stasiselectronics/LowNoise5VDC/LowNoise5V - HW Files/Input Files/artwork-bottom.png

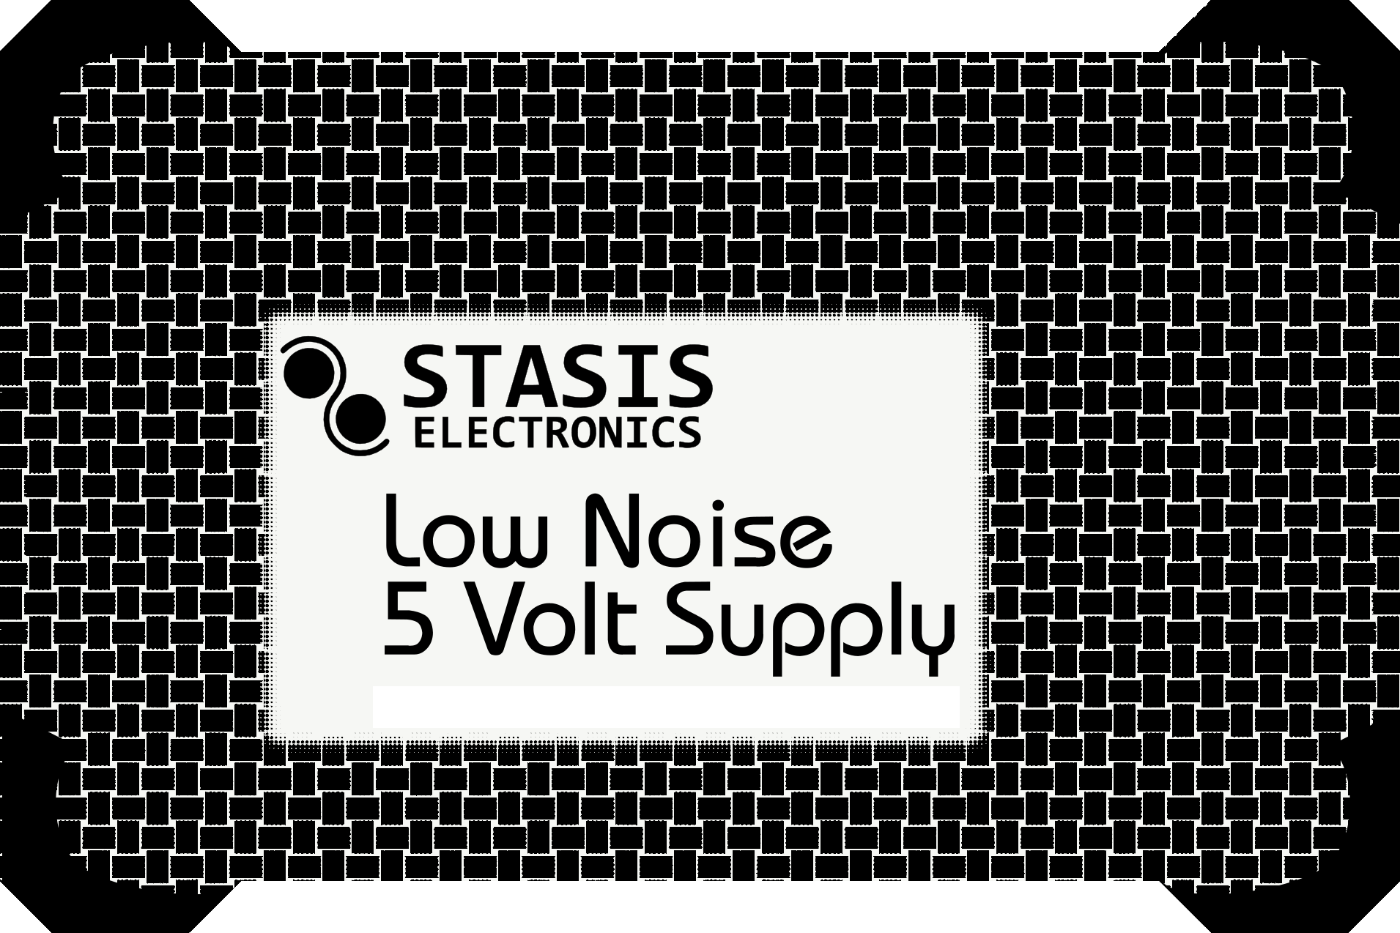
LowNoise5V - HW Files/Input Files/artwork-bottom.png
