stasiselectronics/LowNoise5VDC/LowNoise5V - HW Files/Input Files/artwork-top.png

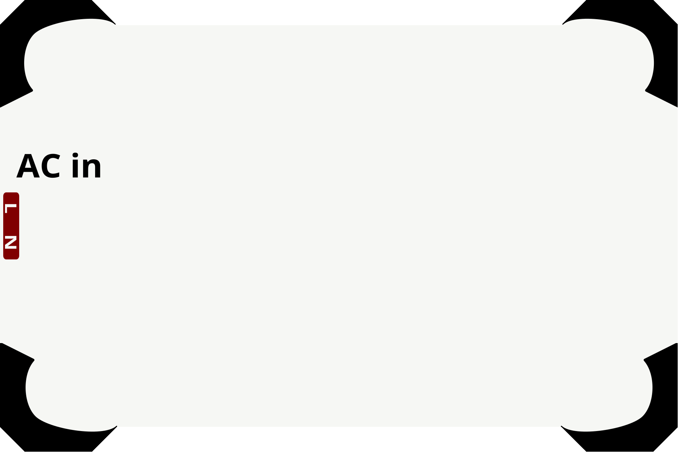
LowNoise5V - HW Files/Input Files/artwork-top.png
