stasiselectronics/LowNoise5VDC/Enclosure Files/Assembly.FCStd

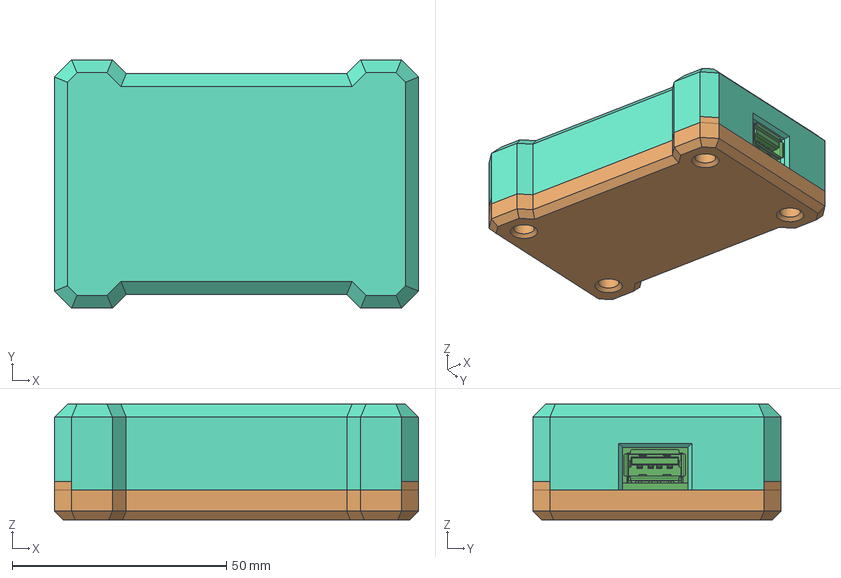
[picture p3: CAD file, 2021-04-17]
Enclosure Files/Assembly.FCStd
85.0 x 58.0 x 27.0 mm
LowNoise5V
