stasiselectronics/LowNoise5VDC/Enclosure Files/STLs/Base.stl

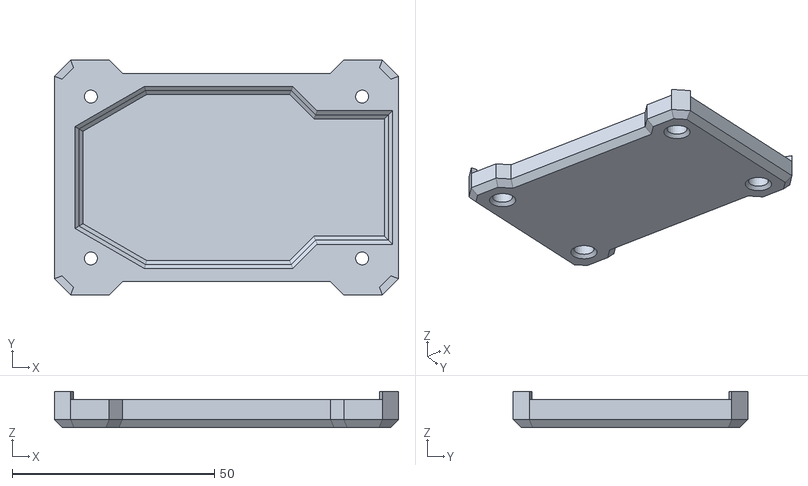
[picture p4: CAD file, 2021-04-17]
Enclosure Files/STLs/Base.stl
85.0 x 58.0 x 9.00
