stasiselectronics/LowNoise5VDC/Enclosure Files/STLs/Top.stl

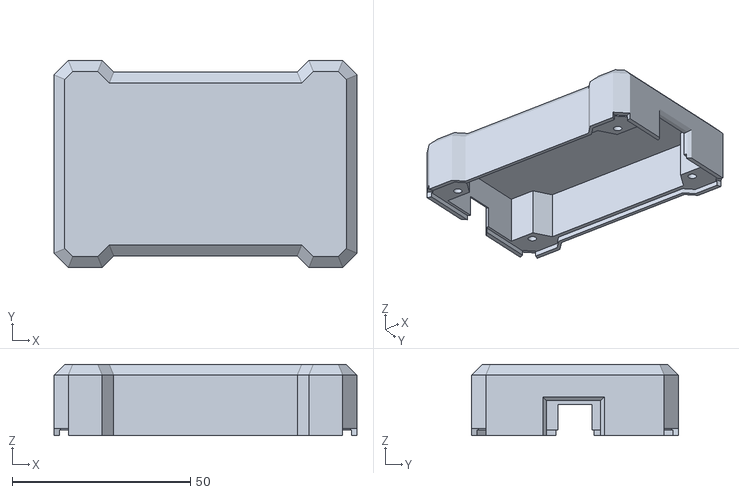
[picture p5: CAD file, 2021-04-17]
Enclosure Files/STLs/Top.stl
85.0 x 58.0 x 20.0
