stasiselectronics/LowNoise5VDC/LowNoise5V - HW Files/LowNoise5V.kicad_pcb

## KiCad design LowNoise5V - HW Files/LowNoise5V.kicad_pcb (2021-04-17)

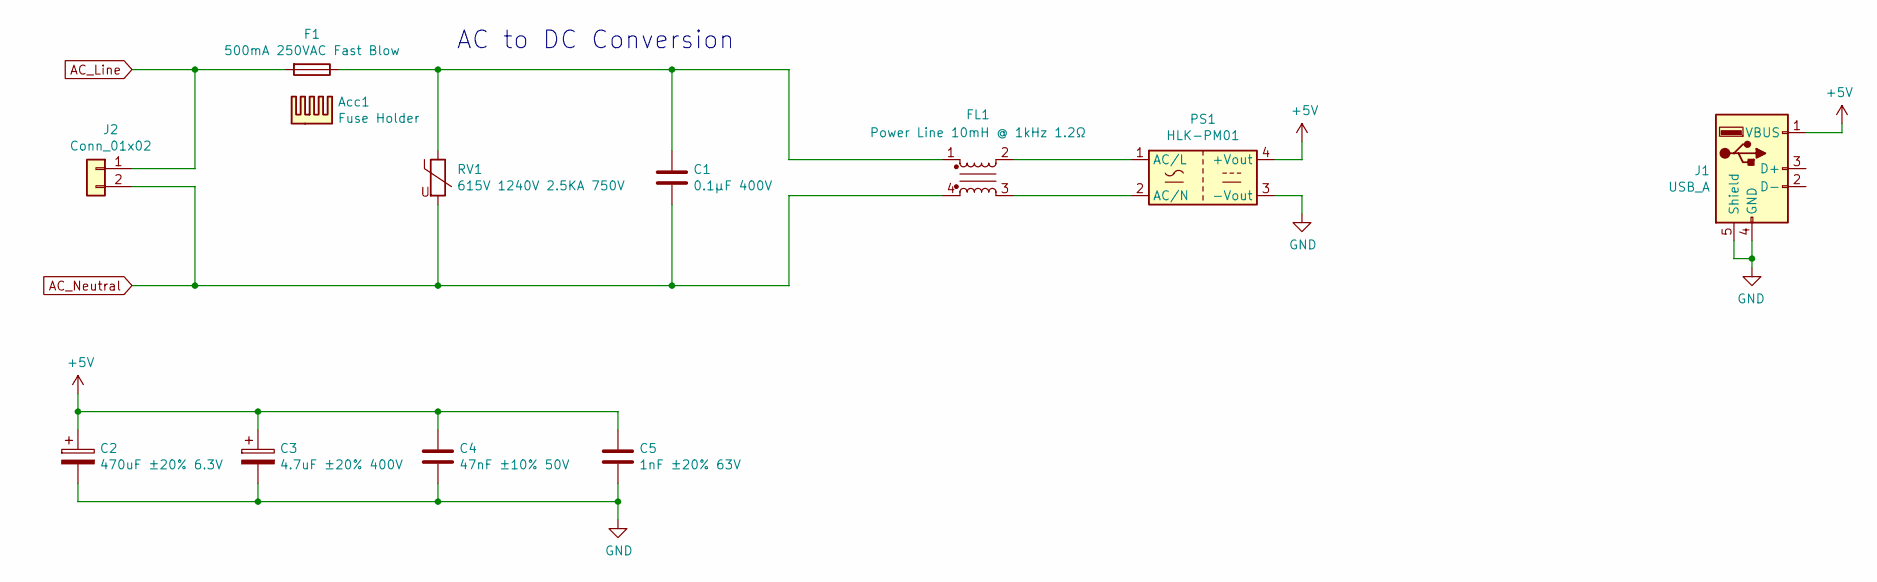
[picture p6: schematic LowNoise5V.sch]

Parts:
Acc1: Fuse Holder; Part 1 MF HONGJU
C1: 0.1µF 400V; C_Rect_L10.0mm_W4.0mm_P7.50mm_MKS4; Part 1 MF Tongfeng
C2: 470uF ±20% 6.3V; CP_Radial_D6.3mm_P2.50mm; Part 1 MF Rubycon
C3: 4.7uF ±20% 400V; CP_Radial_D6.3mm_P2.50mm; Part 1 MF AISHI(Aihua Group)
C4: 47nF ±10% 50V; C_Disc_D6.0mm_W2.5mm_P5.00mm; Part 1 MF Dersonic
C5: 1nF ±20% 63V; C_Disc_D6.0mm_W2.5mm_P5.00mm; Part 1 MF TORCH
F1: 500mA 250VAC Fast Blow; FuseHolder; Part 1 MF Xucheng Elec
FL1: Power Line 10mH @ 1kHz 1.2Ω; EMI Choke; Part 1 MF FH(Guangdong Fenghua Advanced Tech)
J1: USB_A; USB_A_Molex_67643_Horizontal; Part 1 MF Molex
J2: Conn_01x02; 1935161
PS1: HLK-PM01; Converter_ACDC_HiLink_HLK-PMxx; Part 1 MF HI-LINK
RV1: 615V 1240V 2.5KA 750V; C_Rect_L9.0mm_W9.8mm_P7.50mm_MKT; Part 1 MF Hongzhi Elec

Connections:
+5V: C2.1, C3.1, C4.1, C5.1, J1.1 (VBUS), PS1.4 (+Vout)
AC_Line: F1.2, J2.1
AC_Neutral: C1.2, FL1.4, J2.2, RV1.2
GND: C2.2, C3.2, C4.2, C5.2, J1.4 (GND), J1.5 (Shield), PS1.3 (-Vout)
unnamed: C1.1, F1.1, FL1.1, RV1.1
unnamed: FL1.2, PS1.1 (AC/L)
unnamed: FL1.3, PS1.2 (AC/N)

Notes on the sheet:
AC to DC Conversion

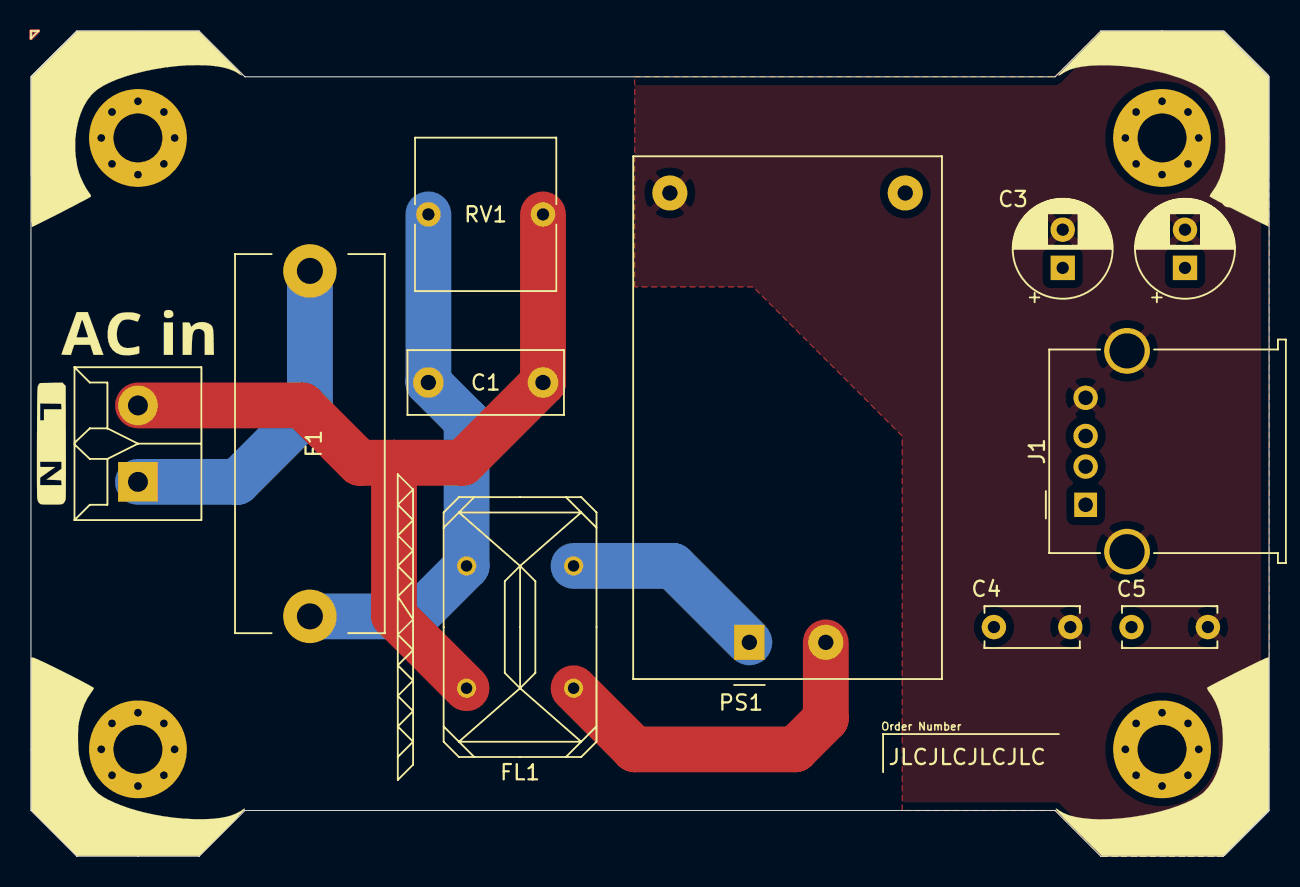
[picture p7: board LowNoise5V.kicad_pcb from above]

Board: 2 copper layers, 81.0 x 54.0 mm, 11 parts (0 on the bottom side), 7 nets.
