stasiselectronics/LowNoise5VDC/(commit log)

2021-03-15 remove schematic used for importing components
    [HotPlateController.sch]
2021-03-15 Update AC side components with part info
    [LowNoise5V.sch]
2021-03-15 Add DC component part info
    [LowNoise5V.sch]
2021-03-15 finalize component part selection and populate some footprints
    [LowNoise5V.kicad_pcb, LowNoise5V.sch]
2021-03-15 Add footprint and symbol library
2021-03-15 Customize footprints and place more components
    [LowNoise5V.kicad_pcb, LowNoise5V.sch]
2021-03-15 move around components
    [LowNoise5V.kicad_pcb]
2021-03-15 move around symbols
    [LowNoise5V.sch]
2021-03-18 Add same screw terminal as in HotPlatController
2021-03-18 Finalize Routing
    [LowNoise5V.kicad_pcb, LowNoise5V.sch]
2021-03-19 add fiduciary mark to silkscreen
    [LowNoise5V.kicad_pcb]
2021-03-19 Finalize Artwork
    [LowNoise5V.kicad_pcb]
2021-03-19 Create Fab files
    [LowNoise5V-B_Cu.gbr, LowNoise5V-B_Mask.gbr, LowNoise5V-B_SilkS.gbr, LowNoise5V-Edge_Cuts.gbr, LowNoise5V-F_Cu.gbr, LowNoise5V-F_Mask.gbr, LowNoise5V-F_SilkS.gbr, LowNoise5V-NPTH.drl]
2021-03-19 Add JLCPCB order number location
    [LowNoise5V-B_Cu.gbr, LowNoise5V-B_Mask.gbr, LowNoise5V-B_SilkS.gbr, LowNoise5V-Edge_Cuts.gbr, LowNoise5V-F_Cu.gbr, LowNoise5V-F_Mask.gbr, LowNoise5V-F_SilkS.gbr, LowNoise5V-job.gbrjob]
2021-03-21 Finalize design files for release
    [LowNoise5V.kicad_pcb]
2021-04-17 Add Enclosure files
    [Assembly.FCStd, Base.stl, Top.stl]
2021-04-17 add dimensions
    [LowNoise5V.kicad_pcb]
